alexlutsenko7/A_Computer/docs/LTari_Keys.docx

LTari — keys

Atari 800XL / 130XE (PAL) on the QMTECH Cyclone IV board: AltirraOS and Altirra BASIC, SD card disk drive (.atr), .xex and cartridges (.car), snapshots, 60 / 50 Hz video, Bluetooth audio (build of 2 November 2026)

All keys below are on the USB keyboard unless a board button is named. The machine menu is described in L64_Keys.docx; LTari has two entries there: 3 LTari 800 (800XL, 64 KB) and 4 LTari 130 (130XE, 128 KB).

# Machine keys

Key | What it does | Notes
F12, keypad / or NumLock | Opens / closes the SD card browser | Lists folders and the .atr, .xex and .car files. See "Usage cases" below.
Alt + F2 / F3 / F4 | The Atari's START / SELECT / OPTION | Held as long as the keys are held. OPTION held while the Atari starts switches BASIC off: Alt + F4 held while pressing KEY0 without a disk (for an .atr the browser asks).
Alt + F5 | The Atari's Reset key | A warm start: BASIC keeps its program.
Alt + F6 | The Atari's Help key
Pause, Alt + F7 | The Atari's Break key
F3 | Opens the Bluetooth audio menu | As on the other machines: scan, connect, PIN, volume. F3 or Esc closes it.
F4 | Opens the joystick menu | DB9-1 = stick 0 (default; player 1 in most games) or swapped. Up / Down, Enter selects, F4 or Esc closes.
F8 | Swaps the video between 60 Hz and 50 Hz | After power-up the picture is 640x480 at 60 Hz; F8 gives 720x576 at 50 Hz. The Atari itself always runs at its real 50 Hz (PAL); at 60 Hz every fifth picture is shown twice. The 50 Hz mode shows every picture once.
F2 | Saves a snapshot | The Atari stops; type a name, Enter saves NAME.A8S in the browser's current folder (Esc: no file), then it runs on. Choosing the .a8s in the browser loads it.
Print Screen | Saves the picture | As SCRNnnnn.BMP (376 x 240, 256 colours) in the browser's current folder.
KEY0 (board button W13) | Resets everything | A cold start: memory cleared, disk and cartridge taken out; the ESP32 restarts.
Ctrl + Alt + Del, or KEY1 (board button Y13) | Back to the machine menu | Ctrl + Alt + Del acts when the keys are released.

F5, F6 and saving to tape are not used on LTari: they show a note or do nothing.

## Browser keys

Key (browser open) | Action
Up / Down, keypad 8 / 2, F9 / F10 | Moves the selection (held: repeats)
Left / Right, keypad 4 / 6, Page Up / Page Down | One page up / down
Enter, keypad Enter, F11 | Opens the folder, or uses the file (see the usage cases); an .atr boots
Shift + Enter on an .atr | Changes the disk in D1: only; the Atari runs on ("insert disk 2")
Enter on an .atr, then F1 / F2 | Boots it with BASIC off (F1) or on (F2); Esc goes back to the list
Esc, Backspace | Up one folder; in the top folder closes the browser
F12 | Closes the browser

While the browser is open the Atari sees no keys.

# Usage cases

## Starting

1. In the machine menu choose 3 LTari 800 or 4 LTari 130. No ROM files are needed: AltirraOS and Altirra BASIC (free replacements by Avery Lee) are in the flash.
2. The monitor gets no signal for about 2 seconds, then the screen turns blue. With no disk the OS asks the disk drive for about a second, then Altirra 8K BASIC shows Ready.

## Booting a disk (.atr)

1. Press F12, choose the .atr file and press Enter. Three lines ask How do you want to load it: <F1> No BASIC <F2> with BASIC; press F1 or F2 (Esc goes back to the list).
2. The note says D1: name; the disk is in drive 1 and the Atari restarts and boots from it.
3. The disk stays in until another one is chosen or KEY0 is pressed. Programs write to it as to a real disk: the .atr on the card changes.
4. Disks made for the old Atari 400 / 800 often need BASIC off (e.g. M.U.L.E.: with BASIC on it hangs on a half-drawn screen): choose F1. The OPTION key is held for you while the Atari starts.
5. To protect an .atr, make the file read-only on the PC (Properties > Read-only): writing then fails with an error, as on a write-protected disk.

## Changing disks (multi-disk programs)

1. Boot the first disk as above (Enter, then F1 or F2).
2. When the program asks for the next disk or side: F12, choose that .atr and press Shift + Enter. The note says Disk changed, D1: name; the Atari was not restarted.
3. Press the key the program asks for (often Return or START) to go on.

## BASIC with a DOS disk

1. Boot a DOS disk (e.g. DOS 2.5 .atr) as above with F2 (with BASIC). BASIC starts with Ready.
2. SAVE "D:NAME" and LOAD "D:NAME" save and load BASIC programs on that disk; DOS opens the DOS menu.

## Running a program file (.xex)

1. Press F12, choose the .xex file and press Enter. The note says Run: name.
2. The Atari restarts, a small loader switches BASIC off and loads the file from a virtual disk (a few seconds), then the program starts.
3. The loader uses memory $0700-$08FF: a program that loads there does not work this way (use an .atr version).

## Plugging in a cartridge (.car)

1. Press F12, choose the .car file and press Enter. The note says Cartridge: name, and the Atari restarts into the cartridge.
2. Supported: standard 8 KB and 16 KB cartridges, Atarimax 128 KB and 1 MB (many newer games). Other types say Cart type not yet.
3. Choosing an .atr or .xex, or KEY0, takes the cartridge out again.

## Without BASIC

1. With a disk: in the browser press Enter on the .atr, then F1 (No BASIC).
2. Without a disk: hold Alt + F4 and press KEY0; keep holding until the screen comes up. (KEY0 also takes a disk out, so use the browser way for disks.)
3. Signs that a disk needs BASIC off: it hangs while starting or shows a half-drawn screen. Most disks for the old 400 / 800 need it; .xex files switch BASIC off by themselves.

## Snapshots

1. Press F2: the Atari stops. Type a name (letters / digits, up to 8) and press Enter: NAME.A8S is saved in the browser's current folder (64 KB file on the 800, 128 KB on the 130). Esc saves nothing. The Atari then runs on.
2. To go back to that moment: F12, choose the .a8s, Enter. Memory, CPU and chip registers are restored and the program runs on from there.
3. Load it on the same model (800 or 130) it was saved on. A cartridge game: load the same .car first, then the snapshot. A disk game that loads more later: if the note says Loaded; disk was NAME, put that disk in with Shift + Enter.
4. Not kept: the exact position in the picture and the chips' internal counters; the program is back in step within a frame.

## 60 Hz or 50 Hz

1. LTari starts at 640x480, 60 Hz. If your monitor also accepts 50 Hz, F8 shows the Atari's own 50 Hz with perfectly smooth scrolling; F8 again goes back to 60 Hz.

## Sound on Bluetooth headphones or a speaker

1. POKEY's sound goes to the 3.5 mm jack and, through the ESP32, to Bluetooth. Press F3, choose Scan, then the device, and Enter.

## Screenshots

1. Press Print Screen: the picture is saved as SCRNnnnn.BMP in the folder the browser shows (the card's top folder after a start).

# The Atari keyboard on a USB keyboard

Keys that the Atari has are on the same PC keys; the others are on keys at the same places as on the Atari:

USB key | Atari key
Letters, digits, Return, Space, Tab, Esc, Caps Lock, Backspace | The same keys (Backspace = Delete / Back S)
- = ; , . / | The same keys
' (apostrophe) | + (Shift: \)
\ (backslash) | * (Shift: ^)
[ and ] | < and > (Shift: Clear / Insert line)
` (back quote) | Inverse video (the Atari logo key)
Up / Down / Left / Right | The cursor keys (Control + - = + *)
Home | Clear screen (Shift + <)
Delete / Insert | Delete / insert a character (Control + Back S / >)
Shift, Ctrl | Shift, Control
Shift + 2 / Shift + 7 / Shift + 8 | " / ' / @ (as printed on the Atari)

# Good to know

- SD card: FAT32 or FAT16, not exFAT. The browser shows folders first, then files, up to 320 per folder.
- The LTari 130 has 128 KB (the 130XE's extra 64 KB in banks of 16 KB); the LTari 800 has 64 KB.
- The chips are new designs from the Atari documentation; some rare hardware tricks may still be missing (see LTari/ep4_ce15/README.md).
