alexlutsenko7/A_Computer/Extra_PCB_CycloneIV_R2/jlcpcb/Extra_PCB_CycloneIV_R2_BOM.csv

Comment | Designator | Footprint | LCSC Part #
6p8 | C1,C2,C3,C4,C5 | C_0603_1608Metric | C318672
0.1u | C6,C8,C13,C15,C16,C17,C21,C22,C26,C28,C29 | C_0603_1608Metric | C14663
10u | C7,C9,C10,C23,C24,C25,C27 | C_0805_2012Metric | C15850
1u | C11,C14 | C_0603_1608Metric | C15849
22u | C12 | C_0805_2012Metric | C45783
4.7u | C18 | C_0603_1608Metric | C19666
100u | C19,C20 | C_1206_3216Metric | C15008
VGA | J2 | DSUB-15-HD_Socket_Horizontal_P2.29x2.54mm_CONNFLY_DS1038 | C75754
Audio out | J3 | Jack_3.5mm_KoreanHropartsElec_PJ-320D-4A_Horizontal | C95562
Joystick 2 / Joystick 1 | J4,J6 | DSUB-9_Pins_Horizontal_P2.77x2.84mm_EdgePinOffset7.70mm_Housed_MountingHolesOffset9.12mm | C75750
USB-C 5V / console | J5 | USB_C_Receptacle_HRO_TYPE-C-31-M-12 | C165948
microSD | J7 | microSD_HC_Molex_104031-0811 | C585350
USB 5V (HDMI dongle) / USB keyboard | J8,J9 | USB_A_Connfly_DS1095 | C19944603
MMBT3904 | Q1,Q2 | SOT-23 | C20526
523 | R1,R5,R9 | R_0603_1608Metric | C23199
1.05k | R2,R6,R10 | R_0603_1608Metric | C22832
2.1k | R3,R7,R11 | R_0603_1608Metric | C22902
4.22k | R4,R8,R12 | R_0603_1608Metric | C23042
22 | R13,R14 | R_0603_1608Metric | C23345
3k3 | R15,R16,R17,R18,R19,R20,R21,R22,R23,R24 | R_0603_1608Metric | C22978
10k | R25,R26,R27,R28,R29,R34,R35,R36,R37 | R_0603_1608Metric | C25804
68 | R30 | R_0603_1608Metric | C27592
2.2k | R31,R32 | R_0603_1608Metric | C4190
1k | R33,R42 | R_0603_1608Metric | C21190
5.1k | R38,R39 | R_0603_1608Metric | C23186
22k | R40 | R_0603_1608Metric | C31850
47.5k | R41 | R_0603_1608Metric | C23061
BOOT / EN | SW1,SW2 | SW_SPST_PTS810 | C116501
LDL1117S33R | U1 | SOT-223-3_TabPin2 | C435835
ESP32-WROVER-E-N16R8 | U2 | ESP32-WROVER-E | C529589
CP2102N-A02-GQFN24 | U3 | QFN-24-1EP_4x4mm_P0.5mm_EP2.6x2.6mm | C969151
CH9350L | U4 | LQFP-48_7x7mm_P0.5mm | C109472
USBLC6-2SC6 | U5,U6 | SOT-23-6 | C7519
