alexlutsenko7/A_Computer/Extra_PCB_CycloneIV/jlcpcb/Extra_PCB_CycloneIV_BOM.csv

Comment | Designator | Footprint | LCSC Part #
6p8 | C1,C2,C3,C4,C5 | C_0603_1608Metric | C318672
0.1u | C6,C13,C14,C15,C16,C17 | C_0603_1608Metric | C14663
10u | C7,C11,C12 | C_0805_2012Metric | C15850
0.1u | C8 | C_Disc_D4.7mm_W2.5mm_P5.00mm | C84772
10u | C9,C10 | C_Disc_D4.7mm_W2.5mm_P5.00mm | C531341
VGA | J2 | DSUB-15-HD_Socket_Horizontal_P2.29x2.54mm_CONNFLY_DS1038 | C75754
Audio out | J3 | Jack_3.5mm_KoreanHropartsElec_PJ-320D-4A_Horizontal | C95562
Joystick 1 / Joystick 2 | J4,J6 | DSUB-9_Pins_Horizontal_P2.77x2.84mm_EdgePinOffset7.70mm_Housed_MountingHolesOffset9.12mm | C75750
microSD | J7 | microSD_HC_Molex_104031-0811 | C585350
523 | R1,R5,R9 | R_0603_1608Metric | C23199
1.05k | R2,R6,R10 | R_0603_1608Metric | C22832
2.1k | R3,R7,R11 | R_0603_1608Metric | C22902
4.22k | R4,R8,R12 | R_0603_1608Metric | C23042
22 | R13,R14 | R_0603_1608Metric | C23345
3k3 | R15,R16,R17,R18,R19,R20,R21,R22,R23,R24 | R_0603_1608Metric | C22978
10k | R25,R26,R27,R28,R29 | R_0603_1608Metric | C25804
68 | R30 | R_0603_1608Metric | C27592
2.2k | R31,R32 | R_0603_1608Metric | C4190
1k | R33 | R_0603_1608Metric | C21190
7803 module | U1 | Module_7803_SIP-3_P2.54mm_Reserve15x12mm | C5369643
