alexlutsenko7/A_Computer/INSTALL/README.txt

L - installing the machines

1. Format a microSD card as FAT32 or FAT16 (not exFAT).
2. Copy LUPDATE.BIN to the root folder of the card.
3. Put the card into the board and switch it on. Wait for "Update complete." (about one minute).

Step by step and in your language: <language>/L_Installation_Guide_<language>.pdf.
Keys, menus, joysticks: <language>/L_User_Manual_<language>.pdf.
Languages: EN English, SP Espanol, PT Portugues, DE Deutsch, UA Ukrainska, RU Russkiy, CN Zhongwen, KR Hangugeo,
JP Nihongo.

Not included: games and other programs, and the Commodore 64 ROMs (copyrighted). Get them yourself; see section 4
of the installation guide.
