alexlutsenko7/A_Computer/docs/L_Build_and_Install.docx

L — build and install

From the sources to a working board: the FPGA images, the one .jic file, the ESP32 firmware, the SD card and the ROMs (state of 11 November 2026)

# 1. What goes where

The finished system has three places that hold software. Each is built and loaded separately:

Where | What | How it gets there
Configuration flash on the core board (W25Q64, 8 MB) | The machine menu, both machines, the Spectrum ROMs; later the C64 ROMs | One file, AMenu/ep4_ce15/output_files/L.jic, programmed over JTAG (USB-Blaster). The C64 ROMs are added by the ESP32 (section 6).
ESP32 (system controller on the I/O board) | SD card loader, on-screen menus, ROM installer, Bluetooth audio | The Arduino sketch ESP32/v2, uploaded over USB (section 4).
microSD card (in the I/O board's socket, read by the ESP32) | Games, tapes, disks, snapshots, and your own C64 ROM files | Copied on a PC (section 5).

At power-up the FPGA always loads the machine menu from flash address 0. Choosing a machine loads that machine's image (Cyclone IV remote update); KEY1 or Ctrl+Alt+Del returns to the menu. Each machine copies its ROMs from the flash into the SDRAM every time it starts.

## Flash layout

Address | Size | Contents
0x000000 | ~500 KB | AMenu, the machine menu (factory image)
0x100000 | ~500 KB | LSpectrum, ZX Spectrum 128K (application image)
0x200000 | ~500 KB | L64, Commodore 64 (application image)
0x300000 | ~500 KB | LTari 800, Atari 800XL (revision LTari800)
0x400000 | ~500 KB | LTari 130, Atari 130XE (revision LTari)
0x500000 | 48 KB | Spectrum ROMs: 128K ROM set + the F1 diagnostics slot (LSpectrum/ep4_ce15/roms48k.hex; the public copy has 48K BASIC there)
0x540000 | 28 KB | LTari ROMs: AltirraOS + Altirra BASIC (free; LTari/ep4_ce15/roms/atarirom.hex)
0x580000 | 48 KB | C64 ROMs: CHAR, BASIC, KERNAL and 1541 DOS. Not in the .jic: written by the ESP32 from your files on the SD card
0x600000 ... | free | room for further machines

Every image has a 1 MB slot, so boards with a larger FPGA use the same layout. The addresses are fixed in three places that must agree: the menu (AMenu/ep4_ce15/rtl/AMenu.v, parameter MACHINE_ADDR), the .cof file (AMenu/ep4_ce15/L.cof) and the machines' ROM loaders (rom_loader.v FLASH_ADDR: its default 0x500000 for the Spectrum, 0x580000 set in c64_system.v, 0x540000 in atari_system.v), plus the ESP32 (update.cpp slots, c64.cpp ROM_BASE) and AMenu/ep4_ce15/tools/mk_update.py (skipped C64 area, menu end). The two LTari images are two revisions of one project: LTari800 (0x300000, 800XL) and LTari (0x400000, 130XE).

# 2. Tools

Tool | Notes
Quartus Prime 25.1std Lite (Windows) | Free edition; includes the Programmer and quartus_cpf. The scripts are written for WSL and call the Windows tools in C:\Altera\quartus\bin64.
USB-Blaster | JTAG cable to the core board's JTAG header.
Arduino IDE / arduino-cli | Core esp32 3.3.2 (Espressif), board ESP32 Dev Module, default partition scheme. arduino-cli comes with the Arduino IDE.
Arduino libraries | ESP32-A2DP 1.8.11 (Phil Schatzmann; not in the Library Manager: copy the GitHub release into the sketchbook's libraries folder) and AAudioLinkFix (copy ESP32/v2/libraries/AAudioLinkFix there too).
Python 3 (optional) | For the tools: L64/ep4_ce15/tools/mk_c64rom.py (a local C64 ROM image for tests), mk_d64.py (a test disk).
Questa FSE (optional) | Intel's free simulator, for the testbenches; not needed to build.

# 3. Building the FPGA images and the .jic

## 3.1 The four Quartus projects

Every project folder (AMenu, LSpectrum, L64, LTari) has one subfolder per core board: ep4_ce15/ for the QMTECH Cyclone IV EP4CE15 board, with all sources, simulations and tools, and 10cl025/ for the QMTECH Cyclone 10 LP 10CL025 board (section 3.4). This section builds for the EP4CE15 board.

Each machine is its own Quartus project; LTari has two revisions (800 and 130). Compile all five (order does not matter); each produces a .sof in its output_files folder:

cd AMenu/ep4_ce15 && quartus_sh --flow compile AMenu # -> output_files/AMenu.sof

cd LSpectrum/ep4_ce15 && quartus_sh --flow compile LSpectrum # -> output_files/LSpectrum.sof

cd L64/ep4_ce15 && quartus_sh --flow compile L64 # -> output_files/L64.sof

cd LTari/ep4_ce15 && quartus_sh --flow compile LTari # -> output_files/LTari.sof (130XE)

cd LTari/ep4_ce15 && quartus_sh --flow compile LTari -c LTari800 # -> output_files/LTari800.sof (800XL)

- In the Quartus GUI: open the .qpf, Processing > Start Compilation.
- A compile takes a few minutes per project. Check that timing is met: the Timing Analyzer summary must show no negative slack (all are fully constrained).
- All images are compiled for remote update (STRATIXIII_UPDATE_MODE REMOTE in the .qsf). Keep that setting: without it the menu cannot start the machine.
- The source files each project uses are listed in its .qsf. The machines share some files in LSpectrum/ep4_ce15/rtl/ (SDRAM controller, ROM loader, tape loader, ESP32 link); LTari also uses L64's c64_video.v (OSD).

## 3.2 Assembling the one .jic

The four .sof files (LTari's twice) and the Spectrum and Atari ROMs are combined into one JTAG Indirect Configuration file, as described by AMenu/ep4_ce15/L.cof:

cd AMenu/ep4_ce15

quartus_cpf -c L.cof # -> output_files/L.jic (+ output_files/L.map)

Part of L.cof | Setting
Device | EPCS64 (the W25Q64 behaves as one), FPGA EP4CE15, Active Serial
Page_0 | output_files/AMenu.sof at 0x000000
Page_1 | ../../LSpectrum/ep4_ce15/output_files/LSpectrum.sof, start address 0x100000
Page_2 | ../../L64/ep4_ce15/output_files/L64.sof, start address 0x200000
Page_3 | ../../LTari/ep4_ce15/output_files/LTari800.sof, start address 0x300000
Page_4 | ../../LTari/ep4_ce15/output_files/LTari.sof, start address 0x400000
Hex data | ../../LSpectrum/ep4_ce15/roms48k.hex at 0x500000 and ../../LTari/ep4_ce15/roms/atarirom.hex at 0x540000 (relative)
Options | EPCS ID check off; a .map file with the addresses

L.map lists where each part ended up; compare it with the flash layout in section 1. In the Quartus GUI the same file is made with File > Convert Programming Files > Open Conversion Setup Data (L.cof) > Generate.

The Spectrum ROM file roms48k.hex is part of the project (Amstrad allows the ROMs for emulator use). The .jic stores its bytes bit-reversed; the ROM loader recognises that by the first byte, so nothing has to be done.

## 3.3 Programming the board

1. Connect the USB-Blaster to the core board's JTAG header and power the board.
2. Quartus Programmer: Hardware Setup = USB-Blaster, mode JTAG, Add File AMenu/ep4_ce15/output_files/L.jic, tick Program/Configure and Verify, Start, and wait for 100 % before touching the board or the cable. From the command line:

quartus_pgm -c USB-Blaster -m JTAG -o "ipv;AMenu/ep4_ce15/output_files/L.jic"

Without Verify, an interrupted write is not noticed: the menu then reports reason 08 (a CRC error in that machine's image) when the machine is chosen. Program the .jic again, with Verify.

3. The Programmer first loads a small flash loader into the FPGA, then writes the flash. When it reports success, switch the board off and on: the menu appears.

For development, a single machine's .sof can be loaded straight into the FPGA over JTAG (it is lost at power-off). The flash is not touched; KEY1 then goes to the menu in the flash.

## 3.4 The Cyclone 10 LP core board (10CL025)

The second core board, QMTECH's 10CL025YU256I7G, has the same size and headers, the same SDRAM and flash. Its projects are in the 10cl025/ subfolders. They hold only the Quartus project and its outputs: the sources, the .sdc and the ROM images are those of ep4_ce15/. State of 11 November 2026: the SDRAM test runs on the board; the menu and the machines build and meet timing but have not been tried on hardware.

python3 tools/mk_10cl025_qsf.py # makes every 10cl025/*.qsf from the ep4_ce15 one

cd AMenu/10cl025 && quartus_sh --flow compile AMenu

cd LSpectrum/10cl025 && quartus_sh --flow compile LSpectrum

cd L64/10cl025 && quartus_sh --flow compile L64

cd LTari/10cl025 && quartus_sh --flow compile LTari

cd LTari/10cl025 && quartus_sh --flow compile LTari -c LTari800

cd AMenu/10cl025 && quartus_cpf -c L.cof # -> output_files/L.jic for the 10CL025

cd AMenu/10cl025 && python3 ../ep4_ce15/tools/mk_update.py # -> output_files/LUPDATE.BIN for the 10CL025

- The 10cl025/*.qsf files are generated: change the ep4_ce15 .qsf (or the tool) and run the tool again. It replaces the device, translates every ball name (on-board parts by signal, the I/O board's signals by their pin of header U8) and points the file paths to ../ep4_ce15.
- Needs the Cyclone 10 LP device support in Quartus (Tools > Install Devices).
- The board has one user key (KEY0). KEY1 is on header U7 pin 7 (ball G1) with a weak pull-up, where a button to ground can be wired; the board's nCONFIG button also returns to the machine menu.
- An `L.jic` or `LUPDATE.BIN` is for one core board only. The update file has no board mark: the file of the other board would leave the FPGA without a valid image, and the board would need the USB-Blaster and its own L.jic.
- Pins: docs/BOARD_PINOUT.md. Flash layout and addresses are the same on both boards.

# 4. The ESP32 firmware

The same firmware serves all machines: it waits for a machine's core ID on the SPI link (LSpectrum 5A580001, L64 43360001, LTari 41540001) and restarts whenever the machine changes.

1. Install the esp32 core 3.3.2 and the two libraries (section 2).
2. Connect the ESP32 board by USB; note its COM port (COM10 on the development PC).
3. Compile and upload, in the top folder of the project (I/O board revision 1; for revision 2 the sketch is ESP32/v2 and the board options are in its README):

arduino-cli compile -b esp32:esp32:esp32 -u -p COM10 ESP32/v1

Or open ESP32/v2/v2.ino in the Arduino IDE, board "ESP32 Dev Module", and Upload. (I/O board revision 1: ESP32/v1/v1.ino.) The sketch uses about 1.17 MB of the 1.25 MB app partition. A change in the ESP32 sources needs only this step; the FPGA flash stays as it is.

# 5. The SD card

1. Use a microSD card formatted FAT32 (or FAT16). exFAT is not supported: most cards above 32 GB come as exFAT and must be reformatted.
2. For L64, make the folder /ROMS/C64/ and copy Commodore ROM files into it that you are entitled to use (they are copyrighted and not part of the project): read from a C64 and 1541 you own, or licensed copies:

File name starts with | Size | Typical file name
KERNAL | 8 KB | kernal-901227-03.bin
BASIC | 8 KB | basic-901226-01.bin
CHAR | 4 KB | chargen-901225-01.bin
DOS1541 or 1541 | 16 KB | dos1541-325302-01+901229-05.bin (without it there is no disk drive)

3. Put games anywhere on the card, in folders as you like (up to 320 entries per folder): Spectrum .tap / .tzx / .z80, C64 .d64 / .prg / .t64 / .tap / .a64. Saved tapes and snapshots are written into the folder the browser is in.

The Spectrum needs nothing on the card to start; its ROMs are in the .jic. The card can be inserted or changed at any time (the browser reads it again).

SD card (FAT32)

├── ROMS/

│ └── C64/

│ ├── kernal-901227-03.bin

│ ├── basic-901226-01.bin

│ ├── chargen-901225-01.bin

│ └── dos1541-325302-01+901229-05.bin

├── Spectrum/ ... (.tap .tzx .z80, any folder names)

└── C64/ ... (.d64 .prg .t64 .tap .a64)

# 6. How the ROMs are used

## 6.1 ZX Spectrum

- The 128K ROMs and the F1 diagnostics slot are in the flash at 0x500000 (from the .jic). The public image has a copy of the 48K BASIC ROM in that slot (DiagROM's licence is not known); LSpectrum/ep4_ce15/tools/mk_roms48k.py builds it with your own DiagROM.
- At every start and reset (power-up via the menu, KEY0) the FPGA's ROM loader copies the 48 KB from the flash into the SDRAM, then starts the Z80. F1 held at that moment selects the diagnostics slot.
- If the flash holds no ROM image (first byte wrong), the board LED blinks fast: program the .jic.

## 6.2 Commodore 64

1. When L64 starts, its ROM loader copies 48 KB from flash 0x580000 into the SDRAM (CHAR, BASIC, KERNAL) and the 1541 DOS ROM into the drive's own memory. The image starts with the header "L64 ROMS"; byte 13 says whether a 1541 ROM is included.
2. The ESP32 checks that header. If the flash has no C64 ROMs yet, it shows "No ROMs in the flash yet", reads KERNAL*, BASIC*, CHAR* and DOS1541* / 1541* from /ROMS/C64/, builds the 48 KB image, writes it into the flash through the FPGA (flash pass-through, sector erase + page program), reads it back to verify, and tells the FPGA to reload: the C64 starts with its ROMs. This takes a few seconds and happens once.
3. From then on L64 starts without the SD card: the ROMs come from the flash every time L64 is started and after KEY0.
4. If the files are missing, the screen says where to put them; add them and press KEY0. Without a DOS1541 file the C64 works but has no disk drive (DEVICE NOT PRESENT); the board LED blinks fast while there is no ROM image at all.

Changing the C64 ROMs later (for example adding the 1541 ROM afterwards) is not automatic yet: the ESP32 installs only when the flash has no C64 ROMs. To make it install again, erase the flash before programming the .jic (Programmer: tick Erase as well as Program/Configure), or erase only the sectors at 0x200000; at the next L64 start the files are installed from the card. Keep the ROM files on the card for that reason.

For local tests only, L64/ep4_ce15/tools/mk_c64rom.py KERNAL BASIC CHAR [DOS1541] OUT makes the same 48 KB image as Intel HEX (to add to a private copy of the .cof at 0x580000) and as a .mem file for the simulation. Such files contain the Commodore ROMs: keep them in the git-ignored L64/ep4_ce15/roms_local/ and never publish a .jic that contains them.

# 7. Updating from the SD card (LUPDATE.BIN)

A board with the machine menu of 30 October 2026 or later updates itself from the card; no USB-Blaster is needed. The update file LUPDATE.BIN has the same contents as L.jic, for the same core board (section 3.4).

1. Copy LUPDATE.BIN to the root folder of the SD card and put the card in.
2. Switch the board on. While the machine menu is shown, the ESP32 finds the file and checks it (header and a CRC-32 over the whole image). The screen shows L update with a progress bar; the menu takes no keys meanwhile. Do not switch off.
3. The ESP32 compares the flash with the file in 4 KB sectors and rewrites only those that differ, each read back: the machines first, the menu last. A small change takes a few minutes of checking and seconds of writing; a full install about 3-4 minutes.
4. When everything checked out, the ESP32 deletes LUPDATE.BIN. If the menu itself changed, the screen says Switch the board off and on; otherwise the menu comes back and the new machines start at once.

Situation | What happens
The file is damaged or not an update file | "not a valid update file": nothing is written, the file stays
The power fails during the update | The file is still on the card; the update runs again at the next start and finishes the job
The power fails while the menu's own sectors are written | The only risky moment (only when the menu changed, written last): the board may need the USB-Blaster and L.jic again
The flash is already up to date | Nothing is written; "(the flash was up to date)"; the file is deleted
C64 ROMs installed by the ESP32 | Never touched (flash 0x580000-0x5FFFFF is skipped)

Making the file, after building the images (section 3), in AMenu/ep4_ce15/:

python3 tools/mk_update.py --label "L 2026-10-30" # -> output_files/LUPDATE.BIN

The tool converts L.cof into a raw flash image (.pof -> .rpd, the flash contents byte for byte) and writes it after a 256-byte header: "LUPDATE1", the image length, its CRC-32, the skipped range (the C64 ROM area), the end of the menu's area and the label shown during the update. The ESP32 code is ESP32/v2/src/update.cpp; its PC test (ESP32_test/v2/test/update_test.cpp, part of run_host_test.sh) runs updates against a flash model, including power cuts at random moments.

# 8. Boards shipped with the loader

AMenu/ep4_ce15/output_files/L_loader.jic holds only the machine menu (the rest of the flash blank): no machines and no ROMs. A board can be passed on with it, and the user installs everything from the public release.

1. Make it in AMenu/ep4_ce15/: python3 tools/mk_update.py --loader.
2. Program L_loader.jic as in 3.3. It holds the menu and blank data up to the end of the 8 MB flash: the Programmer erases only where a .jic has data (its Erase option did not clear old machines on hardware), so this file wipes a used board completely, C64 ROMs included. Then the ESP32 firmware as in section 4.
3. At power-up the board shows No machines installed. Copy LUPDATE.BIN to the SD card's root folder. It looks at the card every 2 seconds.
4. The user copies LUPDATE.BIN from the repository (AMenu/ep4_ce15/output_files/) to the card: the update installs all machines and the Spectrum / Atari ROMs (section 7). For L64 the user adds the C64 ROM files as in section 5.

# 9. Checklist after installing

Check | Expected
Power on | The machine menu: LSpectrum, L64, LTari 800, LTari 130
Start LSpectrum (1) | The 128K menu; F12 shows the card's files (the ESP32 answers)
KEY1, then start L64 (2) | First time: "No ROMs in the flash yet", installing, then the BASIC screen; later: the BASIC screen at once, 38911 BASIC BYTES FREE
F12 in L64, a .d64, Enter | LOAD"*",8,1 is typed, the drive LED (board LED) is on, the program loads in turbo
Ctrl+Alt+Del, then start LTari 130 (4) | Blue screen, then "Altirra 8K BASIC 1.59" and Ready
F8 | The picture switches between 60 Hz (640x480) and 50 Hz (720x576)
F3 | The Bluetooth menu (the ESP32's Bluetooth part answers)

Licences, our own work and the same build steps in one file: BUILDING_AND_LICENSES.md in the repository root. Keys and usage of each machine: docs/LSpectrum_Keys.docx, docs/L64_Keys.docx and docs/LTari_Keys.docx. Wiring of the boards: docs/LSpectrum_Connection.docx. Third-party parts and licences: docs/L_Third_Party.docx.
