alexlutsenko7/A_Computer/docs/L64_Test_Plan.xlsx

Sheet: Test Plan
ID | Area | Test | Steps | Expected result | Needs | Result | Notes
T01 | Start | Clean start into BASIC | Power on. In the menu choose 2 L64. | Monitor: no signal for ~2-3 s, then the BASIC screen. No coloured line at the right. Board LED off. | - | Pass
T02 | Start | KEY0 restart | In BASIC type 10 PRINT "X", then press KEY0. | No signal ~2-3 s, then a fresh BASIC screen; LIST shows nothing (RAM cleared). ESP32 OSD works afterwards (F12). | - | Pass
T03 | Start | Krackout + Ctrl+Alt+Del | Load Krackout (.d64), let it start. Ctrl+Alt+Del, choose L64 again, load Krackout again. | C64 starts into BASIC (no flashing pattern). Krackout loads and runs the second time too. | Good copy of cp krackout.d64 on the card | Pass
T04 | Start | Krackout + KEY0 | Load Krackout, let it start, press KEY0. Load Krackout again. | BASIC after KEY0; Krackout loads again. On the PC the card's .d64 is unchanged (compare with the local copy). | Good copy of cp krackout.d64 | Pass
T05 | Start | Machine switching | Menu -> LSpectrum -> KEY1 -> L64 -> Ctrl+Alt+Del -> LSpectrum, a few rounds. | Each machine starts; the ESP32 OSD (F12) works in each; no restart loop of the ESP32. | - | Pass
T06 | Video | No right-edge line | Do 5 starts (menu and KEY0) in BASIC, light-blue border. | Never a line next to the right border. Optional scope: HSYNC spike on a colour line smaller than before (+-40 mV). | Optional: scope | Pass
T07 | Video | F8 50 / 60 Hz | F8, wait, F8 again. | 50 Hz picture, then 60 Hz again; the C64 runs on. | Monitor with 50 Hz | Pass
T08 | Disk | Directory | F12, choose a .d64. Esc if the LOAD starts. LOAD"$",8 and LIST. | LOAD"*",8,1 typed at the prompt; directory listed. | Any .d64 | Pass
T09 | Disk | Save to disk | On a COPY of a .d64 with free blocks: 10 PRINT "DISK OK" ; SAVE "DTEST",8 | LED on while saving, READY., no blinking afterwards. LOAD"$",8 / LIST: DTEST listed, blocks free reduced. | Spare .d64 (copy)
T10 | Disk | Saved file survives a restart | Ctrl+Alt+Del, L64, F12 the same .d64, LOAD"DTEST",8, RUN. | Prints DISK OK. On the PC: only BAM / directory / DTEST sectors differ from the copy; no track of FF. | Same .d64; PC to compare
T11 | Disk | Scratch and rename | SAVE "DTEST2",8 ; OPEN15,8,15,"R:NEW=DTEST2":CLOSE15 ; OPEN15,8,15,"S:DTEST":CLOSE15 ; directory. | NEW listed, DTEST and DTEST2 gone, blocks free back up. | Same .d64
T12 | Disk | Read-only .d64 | On the PC make a .d64 copy read-only (Properties > Read-only). F12 it, then SAVE "RO",8. | ?WRITE PROTECT / LED blinks (DOS error 26); on the PC the file is unchanged. | Read-only .d64 copy
T13 | Disk | Disk change in BASIC | F12 disk A, LOAD"$",8, LIST. F12 disk B, LOAD"$",8, LIST. | Second listing shows disk B's name and files (not disk A's). | Two different .d64
T14 | Disk | Disk change in a running game | Start a multi-disk game (or any program), then F12 another .d64 while it runs. | Nothing is typed into the program; a game asking for disk 2 continues loading from it. | Multi-disk game, or any game + 2nd .d64
T15 | Disk | Normal speed load | F6 (normal), load a .d64 game. | Loads at 1541 speed (~1-2 min) and runs. F6 back to turbo. | Any .d64 game
T16 | Tape | Save to tape, load back | 10 PRINT "TAPE OK". F12, [Save to this folder], name TTEST, Enter. SAVE "TTEST". READY., then F12. KEY0, LOAD, F12 TTEST.TAP. | TTEST.TAP on the card; FOUND TTEST, LIST shows the line, RUN prints TAPE OK. | -
T17 | Tape | Tape at normal speed | As above with F6 = normal. | Same result, slower. | -
T18 | Tape | Commercial .tap game | LOAD, then F12 a .tap game. Try F11 (pause / continue) and F7 (stop). | Loads and runs in turbo; pause and stop work. If a turbo loader fails: F6 normal and retry. | .tap game
T19 | Files | BASIC .prg | F12 a BASIC .prg. | Program in memory and started (RUN typed). | BASIC .prg | Pass
T20 | Files | Machine-code .prg | F12 a machine-code .prg. | Bottom line shows the load range (e.g. $C000-$C3FF); the program's SYS starts it. | Machine-code .prg
T21 | Files | .t64 | F12 a .t64. | Loaded as the .prg tests. | .t64 file
T22 | Sound | SID 6581 / 8580 (F5) | Play music with filter, press F5, again F5. Listen on the jack and Bluetooth. | Audible filter difference; OSD shows the SID type; no silence or glitch. | Game with music; BT speaker | Pass
T23 | Sound | Bluetooth volume | Connect the BT speaker (F3). | Volume right from the start; reconnects after KEY0. | BT speaker
T24 | Joystick | F4 mode 1: DB9-1 = port 2 | F4, choose mode 1. In BASIC: PRINT PEEK(56320) with DB9-1 directions / fire; PRINT PEEK(56321) with DB9-2. | DB9-1 changes port 2 ($DC00), DB9-2 port 1 ($DC01). Game control works. | 2 joysticks
T25 | Joystick | F4 mode 2: swapped | F4, mode 2; same checks. | DB9-1 on port 1, DB9-2 on port 2. | 2 joysticks
T26 | Joystick | F4 mode 3: both on port 2 | F4, mode 3; same checks. | Both DB9 move port 2. | 2 joysticks
T27 | Snapshots | F2 save / load | In a game (drive idle) F2, name, Enter. KEY0. F12 the .A64. | Game continues where it was saved. | Any game
T28 | Snapshots | Print Screen | Print Screen in BASIC and in a game. | SCRNnnnn.BMP on the card shows the screen (400 x 284). | -
T29 | ROMs | 1541 ROM added later | Optional (needs a ROM image without the 1541 ROM in flash): with DOS1541* in /ROMS/C64, start L64. | OSD 'Adding the 1541 ROM to the flash', C64 restarts, the drive works. | Optional
T30 | LSpectrum | Spectrum regression | Start LSpectrum: F12 a .tap and a .z80, F2 snapshot, Print Screen, KEY0. | All work as before (the ESP link changed in both machines). | ZX .tap and .z80 | Pass

Sheet: Summary
L64 final test round
Hardware: L.jic 2026-10-29 12:06 (programmed with verify), ESP32 sketch 1,175,375 bytes
Tests | 30
Pass | 11
Fail | 0
Skipped | 0
Not run yet | 19
Done | 36.66666667%
How to use
Fill in only the yellow columns of 'Test Plan': Result (drop-down: Pass / Fail / Skipped) and Notes.
Notes example: "Fail: LED blinks after SAVE, PRINT shows 26 WRITE PROTECT ON" or "Pass, 1:40 min at normal speed".
Keep a PC copy of every .d64 you write to, and compare after the disk tests.
The counts above update by themselves.
