alexlutsenko7/A_Computer/docs/LTari_Test_Plan.xlsx

Sheet: Test Plan
ID | Area | Test | Steps | Expected result | Needs | Result | Notes
T01 | Start | Menu with four machines | Power on. | The menu lists 1 LSpectrum, 2 L64, 3 LTari 800, 4 LTari 130. | -
T02 | Start | LTari 130 boots | Choose 4 LTari 130 (no disk inserted). | No signal ~2 s, blue screen; ~1 s later "Altirra 8K BASIC 1.59" and "Ready". | -
T03 | Start | 130XE extra memory | In LTari 130 type: POKE 16384,11:POKE 54017,225:POKE 16384,77:POKE 54017,253:?PEEK(16384) | Prints 11 (the 77 went into extended bank 0, not main RAM). | -
T04 | Start | LTari 800 has no extra memory | Ctrl+Alt+Del, choose 3 LTari 800, type the same line as the test before. | Prints 77 (no banking on the 800XL). | -
T05 | Keys | Typing | Type letters, digits, Shift+digits, - = ; , . / and ' \ [ ] ` , Caps Lock, Backspace. | Each key gives the Atari character from the README table; ` toggles inverse video. | -
T06 | Keys | Cursor and editing | Arrows, Home, Delete, Insert on a typed line. | Arrows move the cursor; Home clears the screen; Delete removes / Insert opens a character. | -
T07 | Keys | Break | Type 10 GOTO 10, RUN, then press Pause. | "Stopped at line 10" (or similar) and Ready. | -
T08 | Keys | Console keys | Type 10 ?PEEK(53279):GOTO 10, RUN; hold Alt+F2, then Alt+F3, then Alt+F4; Pause to stop. | 7 with nothing held; 6 / 5 / 3 while START / SELECT / OPTION are held. | -
T09 | Keys | Reset key | Type 10 ?1, then Alt+F5, then LIST. | Screen restarts into Ready; LIST still shows line 10 (warm start keeps the program). | -
T10 | Keys | No BASIC with OPTION | In LTari 130 hold Alt+F4, press KEY0, keep holding until the screen comes up. | No Altirra BASIC banner (the OS's own screen instead). | -
T11 | Sound | POKEY tone | SOUND 0,121,10,8 then SOUND 0,0,0,0 | A steady tone (about middle C) on the audio jack and Bluetooth; silence after the second command. | Speaker or headphones
T12 | Sound | Keyboard click | Type a few keys with sound on. | A short click per key (console speaker). | -
T13 | Joystick | Stick 0 | Type 10 ?STICK(0),STRIG(0):GOTO 10, RUN; move the joystick in DB9-1, press fire. | 15 1 at rest; 14 up, 13 down, 11 left, 7 right; STRIG 0 while fire is held. | Joystick
T14 | Joystick | Stick 1 and F4 swap | Same with STICK(1),STRIG(1) and the joystick in DB9-2; then F4 -> DB9-1 = stick 1. | DB9-2 drives stick 1; after the swap DB9-1 drives stick 1. | Joystick
T15 | Video | F8 50 / 60 Hz | F8, wait, F8 again. | 50 Hz picture, then 60 Hz again; the Atari keeps running; no line at the right edge. | -
T16 | Video | Graphics modes | GRAPHICS 7:COLOR 1:PLOT 0,0:DRAWTO 159,79 then GRAPHICS 8:COLOR 1:PLOT 0,0:DRAWTO 319,159 | A diagonal line in each mode, the second one thinner (hi-res). | -
T17 | Video | GTIA mode 9 (16 shades) | GRAPHICS 9:FOR I=0 TO 15:COLOR I:PLOT I*4,0:DRAWTO I*4,150:NEXT I:FOR I=1 TO 2000:NEXT I | 16 vertical bars from black to white in one colour. | -
T18 | Video | Colours | SETCOLOR 2,3,6 then SETCOLOR 4,9,4 | Background turns red-orange; then the border turns blue. | -
T19 | Video | Player graphics | 10 POKE 54279,128:POKE 559,46:POKE 53277,3:POKE 704,68:POKE 53248,120 20 FOR I=0 TO 127:POKE 33280+I,0:NEXT I 30 FOR I=50 TO 57:POKE 33280+I,255:NEXT I RUN | A small purple-red square in the middle of the screen, over the text. | -
T20 | Disk | .atr boot | F12, choose a bootable .atr (a DOS disk or a game). | Note "D1: name", the Atari restarts and boots it (the ESP32's serial log shows no errors). | .atr on the card
T21 | Disk | .atr write | Boot a DOS 2.x .atr (with BASIC), type 10 ?1, SAVE "D:TEST", NEW, LOAD "D:TEST", LIST. | Line 10 comes back; on the PC the .atr has changed (compare with the copy). | DOS .atr, PC copy
T22 | Disk | .xex | F12, choose an .xex game. | Note "Run: name", the Atari restarts, loads (a few seconds) and runs the program. | .xex on the card
T23 | Disk | .car | F12, choose a standard 8 KB or 16 KB .car, then an Atarimax 128 KB / 1 MB .car (many newer games). | Note "Cartridge: name", the Atari restarts into the cartridge. Other types: "Cart type not yet". | .car on the card
T24 | System | Screenshot | In BASIC with some text on the screen press Print Screen. | Note "Saved SCRNnnnn.BMP"; on the PC the BMP shows the Atari screen (376 x 240) in the right colours. | SD card
T25 | System | Back to the menu | Ctrl+Alt+Del in LTari; then KEY1 in LTari. | The menu each time; LSpectrum and L64 still start and work (F12 OSD in each). | -
T26 | System | KEY0 | In LTari press KEY0. | A fresh start into BASIC (cartridge removed); the ESP32 restarts, F12 works. | -

Sheet: Summary
LTari first test round
Hardware: L.jic and ESP32 sketch built 2026-10-29 evening (ESP32 still to upload)
Tests
Pass
Fail
Skipped
Not run yet
Done
How to use
Fill in only the yellow columns of 'Test Plan': Result (drop-down: Pass / Fail / Skipped) and Notes.
Notes example: "Fail: Error 138 after the second sector" or "Pass, booted in 6 s".
Keep a PC copy of every .atr you write to, and compare after the disk tests.
Type the BASIC lines exactly; on this keyboard + is the ' key, " is Shift+2, : is Shift+;, * is \.
The counts above update by themselves.
