alexlutsenko7/A_Computer/tests/jtag_rig/results/screens.png

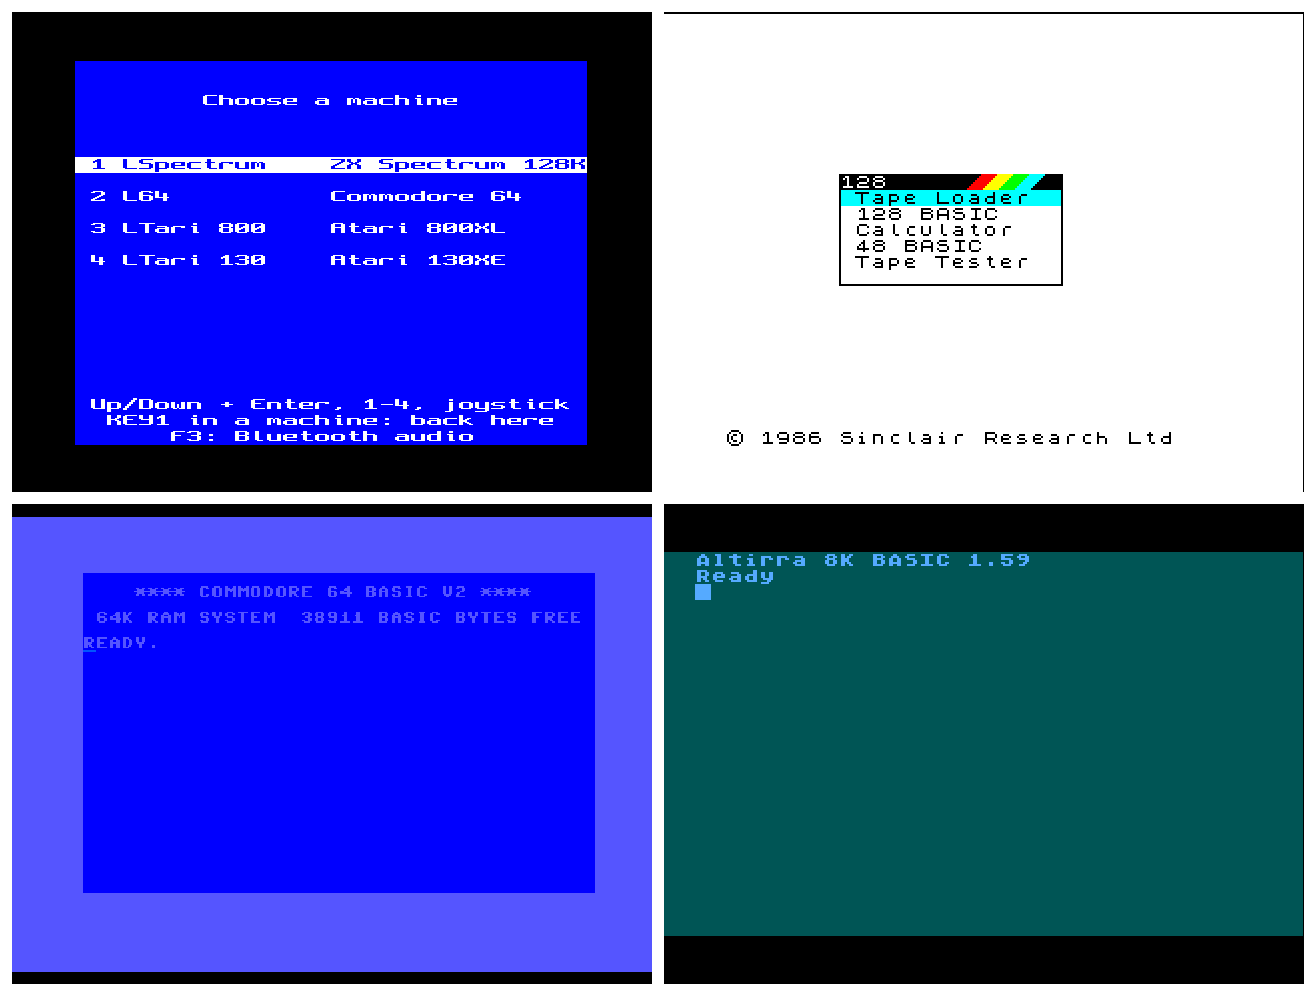
tests/jtag_rig/results/screens.png
