alexlutsenko7/A_Computer/Extra_PCB_CycloneIV_R2/Extra_PCB_CycloneIV_R2.pdf

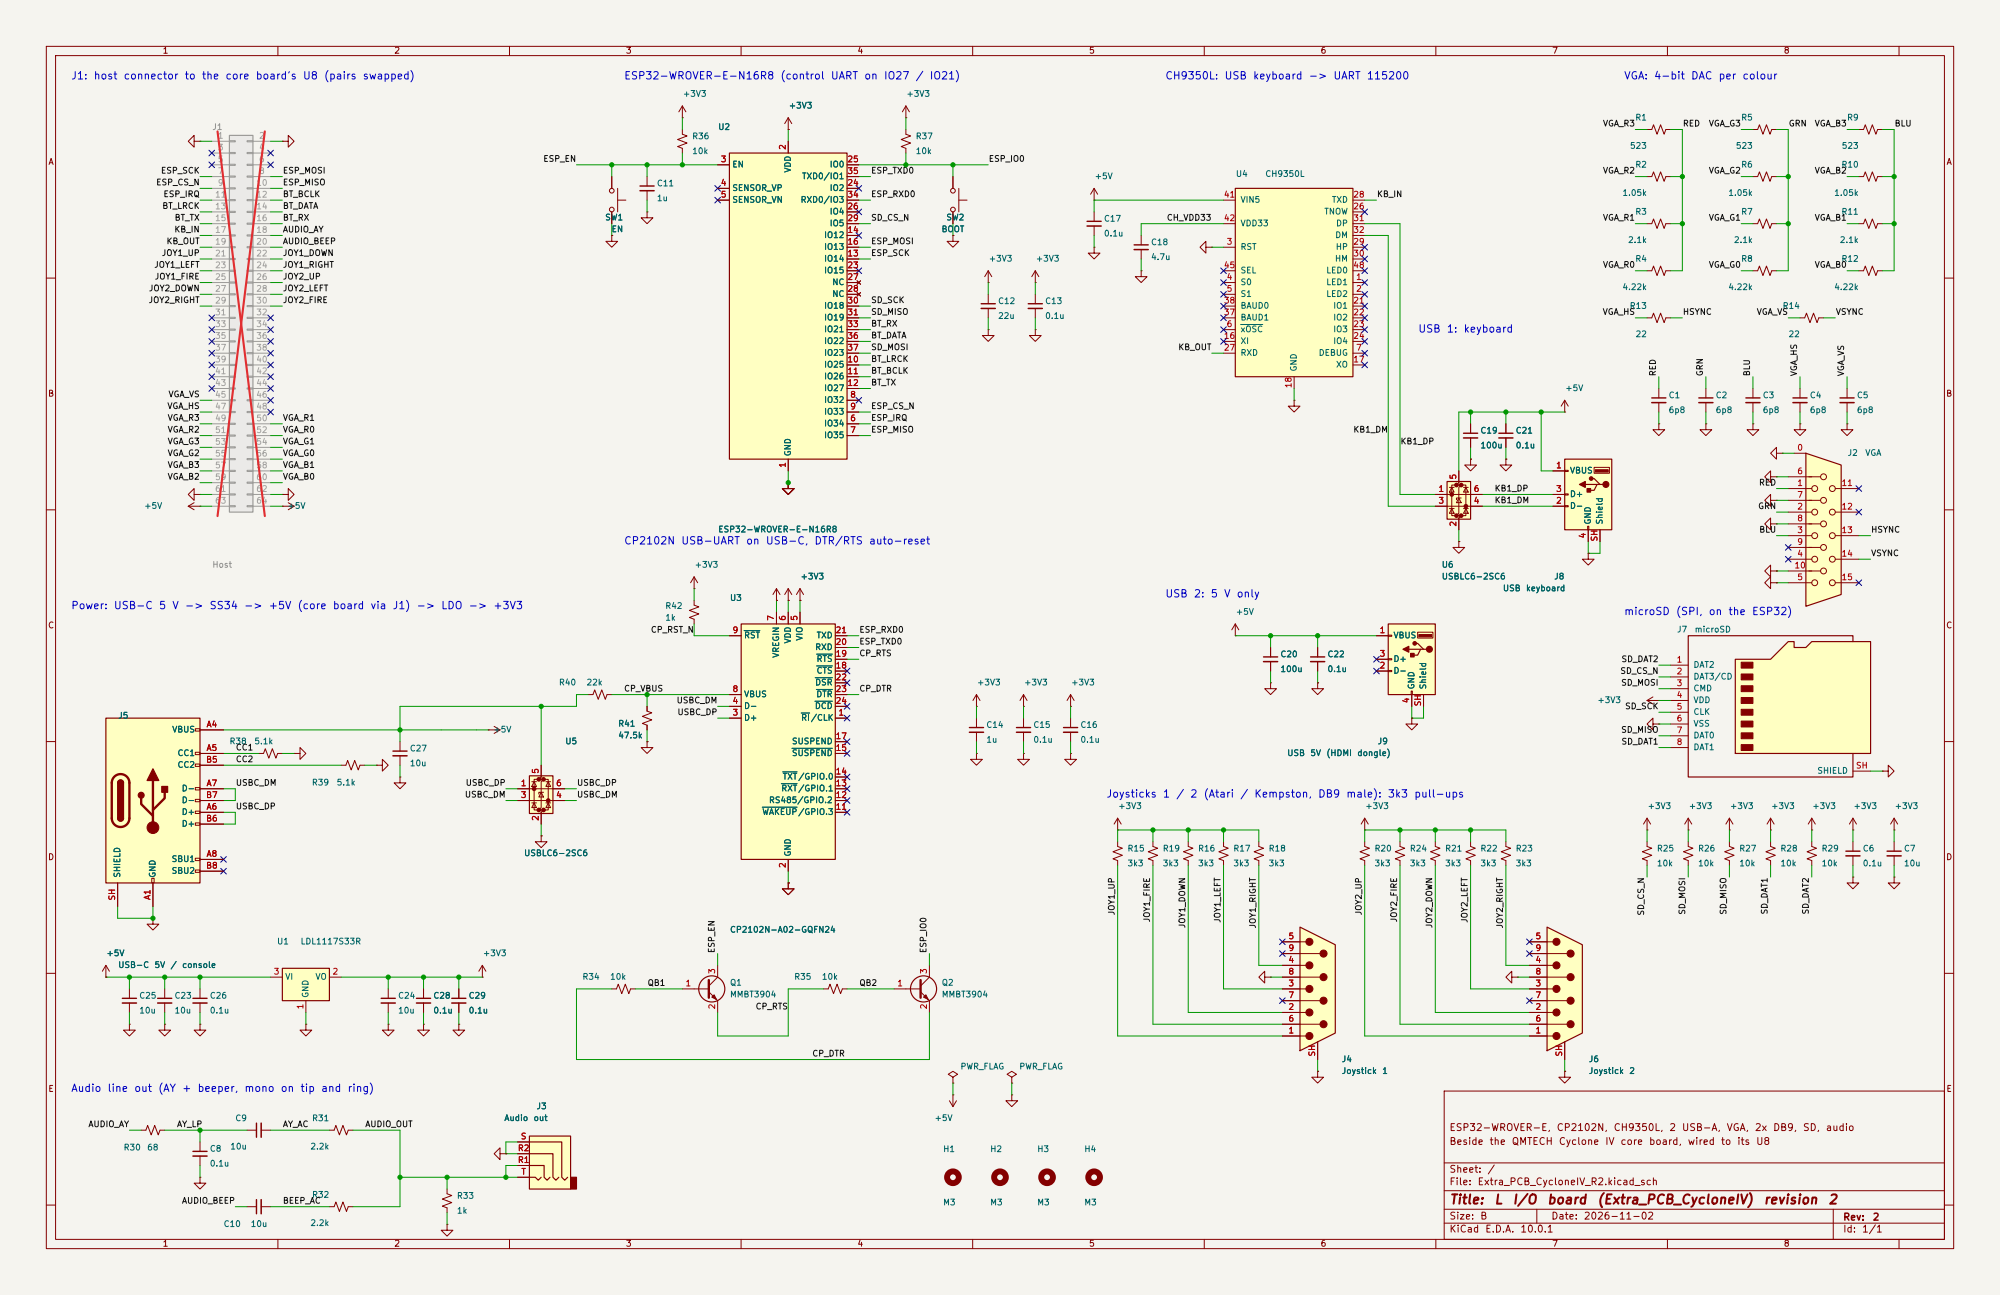
[picture p4: page 1]

KB1_DP Power: USB-C 5 V -> SS34 -> +5V (core board via J1) -> LDO -> +3V3

CP2102N USB-UART on USB-C, DTR/RTS auto-reset

microSD (SPI, on the ESP32)

SUSPEND 15 SUSPEND 17 CTS 18 RTS 19 RXD 20 TXD 21 DSR 22 DTR 23 DCD 24 U5 USBLC6-2SC6

Joysticks 1 / 2 (Atari / Kempston, DB9 male): 3k3 pull-ups

Audio line out (AY + beeper, mono on tip and ring)

ESP32-WROVER-E, CP2102N, CH9350L, 2 USB-A, VGA, 2x DB9, SD, audio
Beside the QMTECH Cyclone IV core board, wired to its U8

Size: B | Rev: 2
KiCad E.D.A. 10.0.1 | Id: 1/1
