alexlutsenko7/A_Computer/Extra_PCB_CycloneIV/Extra_PCB_CycloneIV.pdf

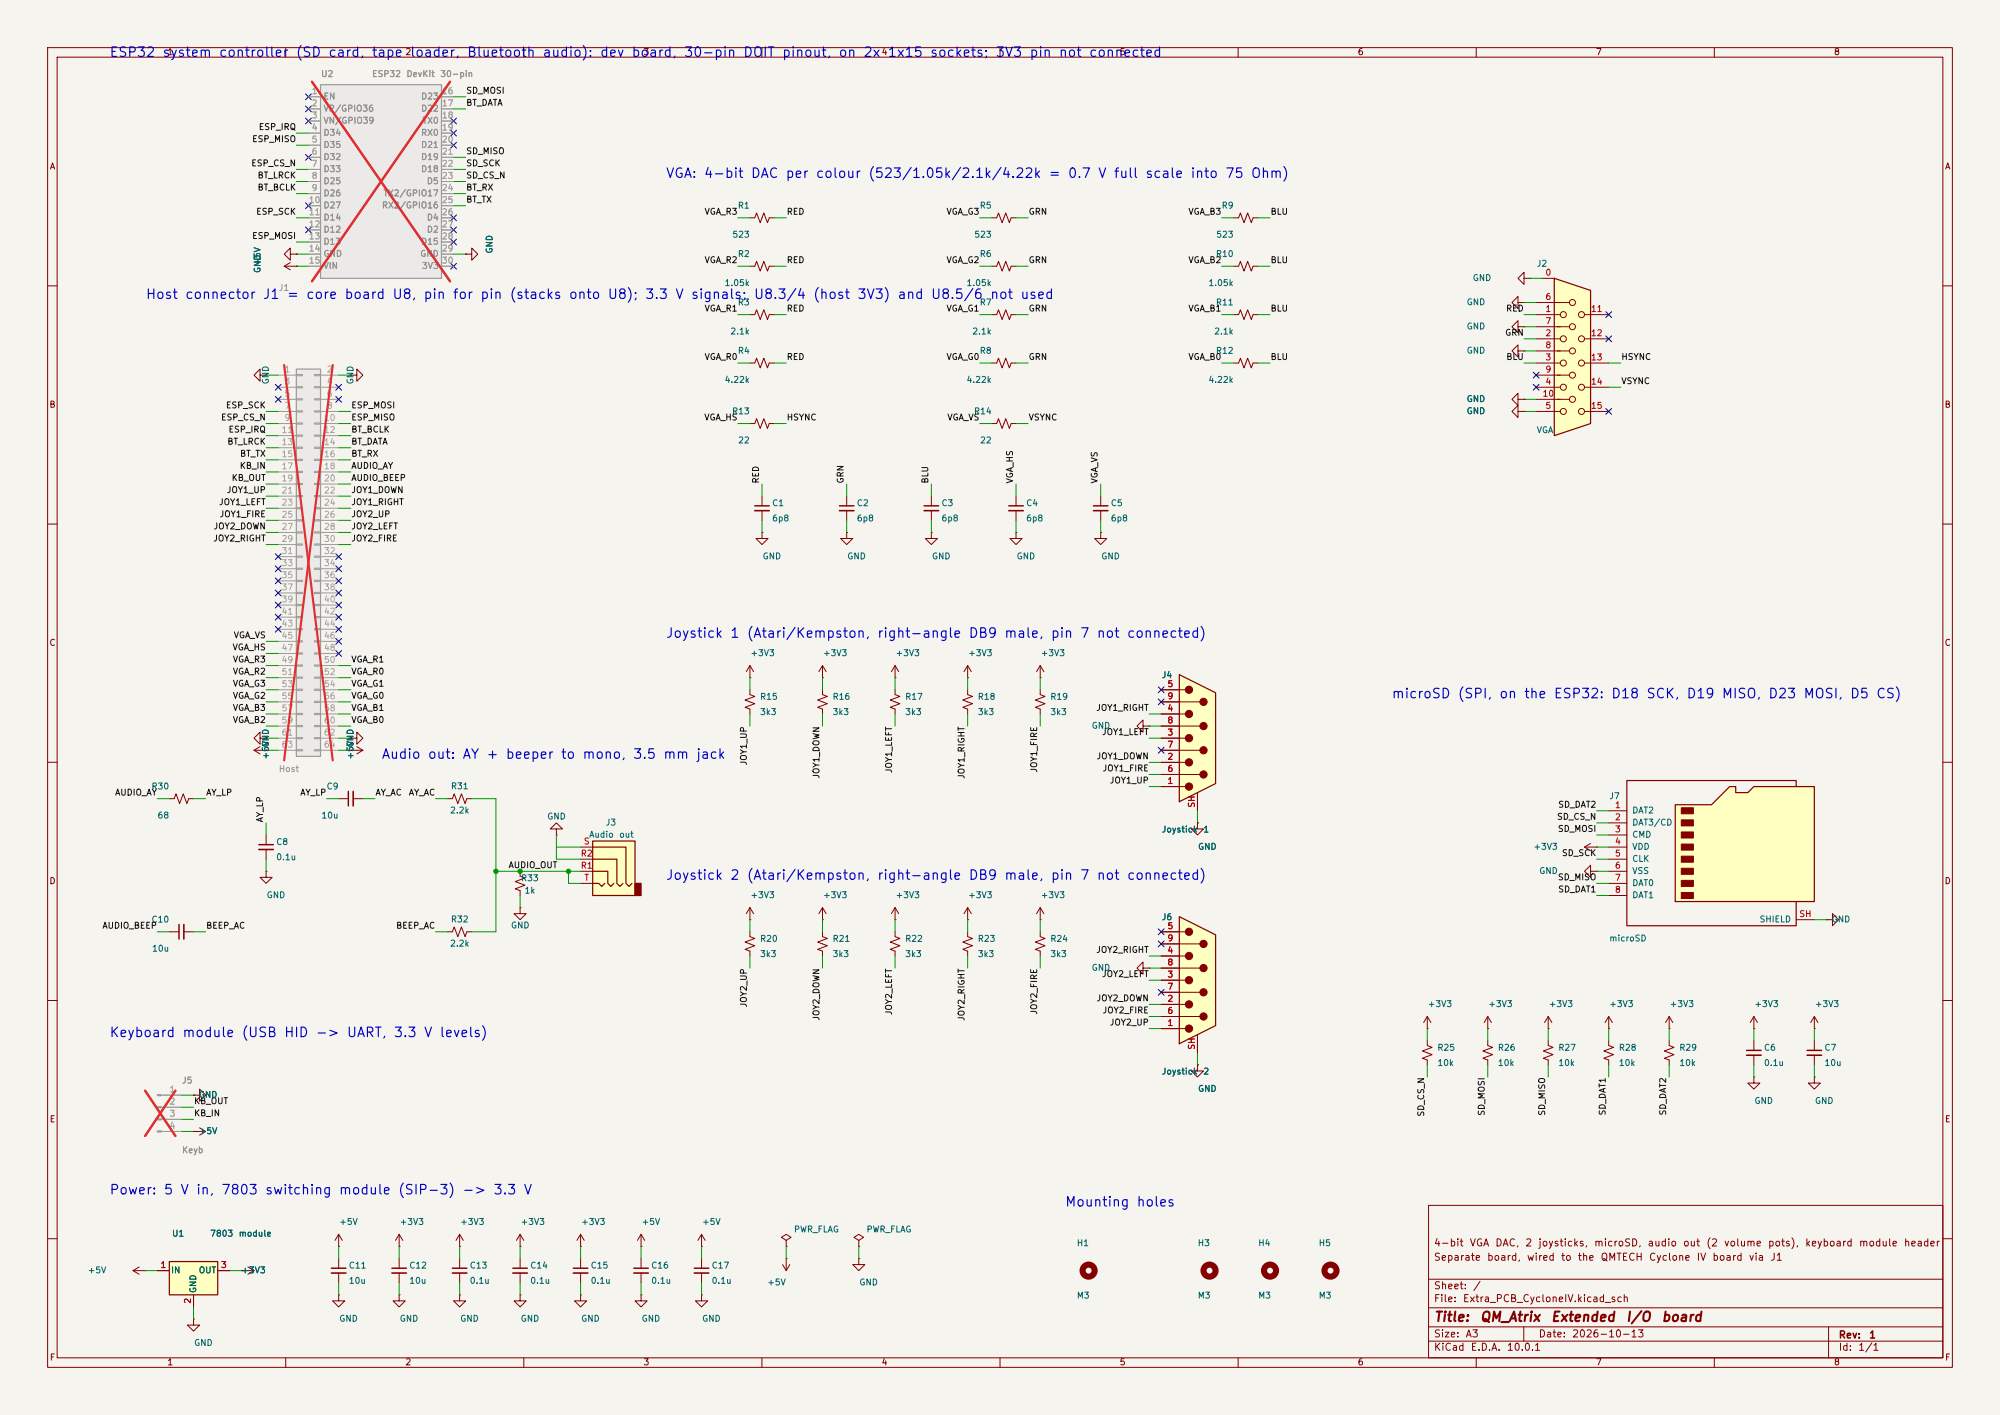
[picture p5: page 1]

ESP32 system controller (SD card, tape loader, Bluetooth audio): dev board, 30-pin DOIT pinout, on 2x 1x15 sockets; 3V3 pin not connected

VGA: 4-bit DAC per colour (523/1.05k/2.1k/4.22k = 0.7 V full scale into 75 Ohm)

Host connector J1 = core board U8, pin for pin (stacks onto U8); 3.3 V signals; U8.3/4 (host 3V3) and U8.5/6 not used

Joystick 1 (Atari/Kempston, right-angle DB9 male, pin 7 not connected)

Audio out: AY + beeper to mono, 3.5 mm jack

Power: 5 V in, 7803 switching module (SIP-3) -> 3.3 V

4-bit VGA DAC, 2 joysticks, microSD, audio out (2 volume pots), keyboard module header
Separate board, wired to the QMTECH Cyclone IV board via J1

Size: A3 | Rev: 1 | F Date: 2026-10-13
KiCad E.D.A. 10.0.1 | Id: 1/1
