alexlutsenko7/A_Computer/Extra_PCB_CycloneIV_R2/Extra_PCB_CycloneIV_R2.kicad_pcb

## KiCad design Extra_PCB_CycloneIV_R2/Extra_PCB_CycloneIV_R2.kicad_pcb (2026-11-09)

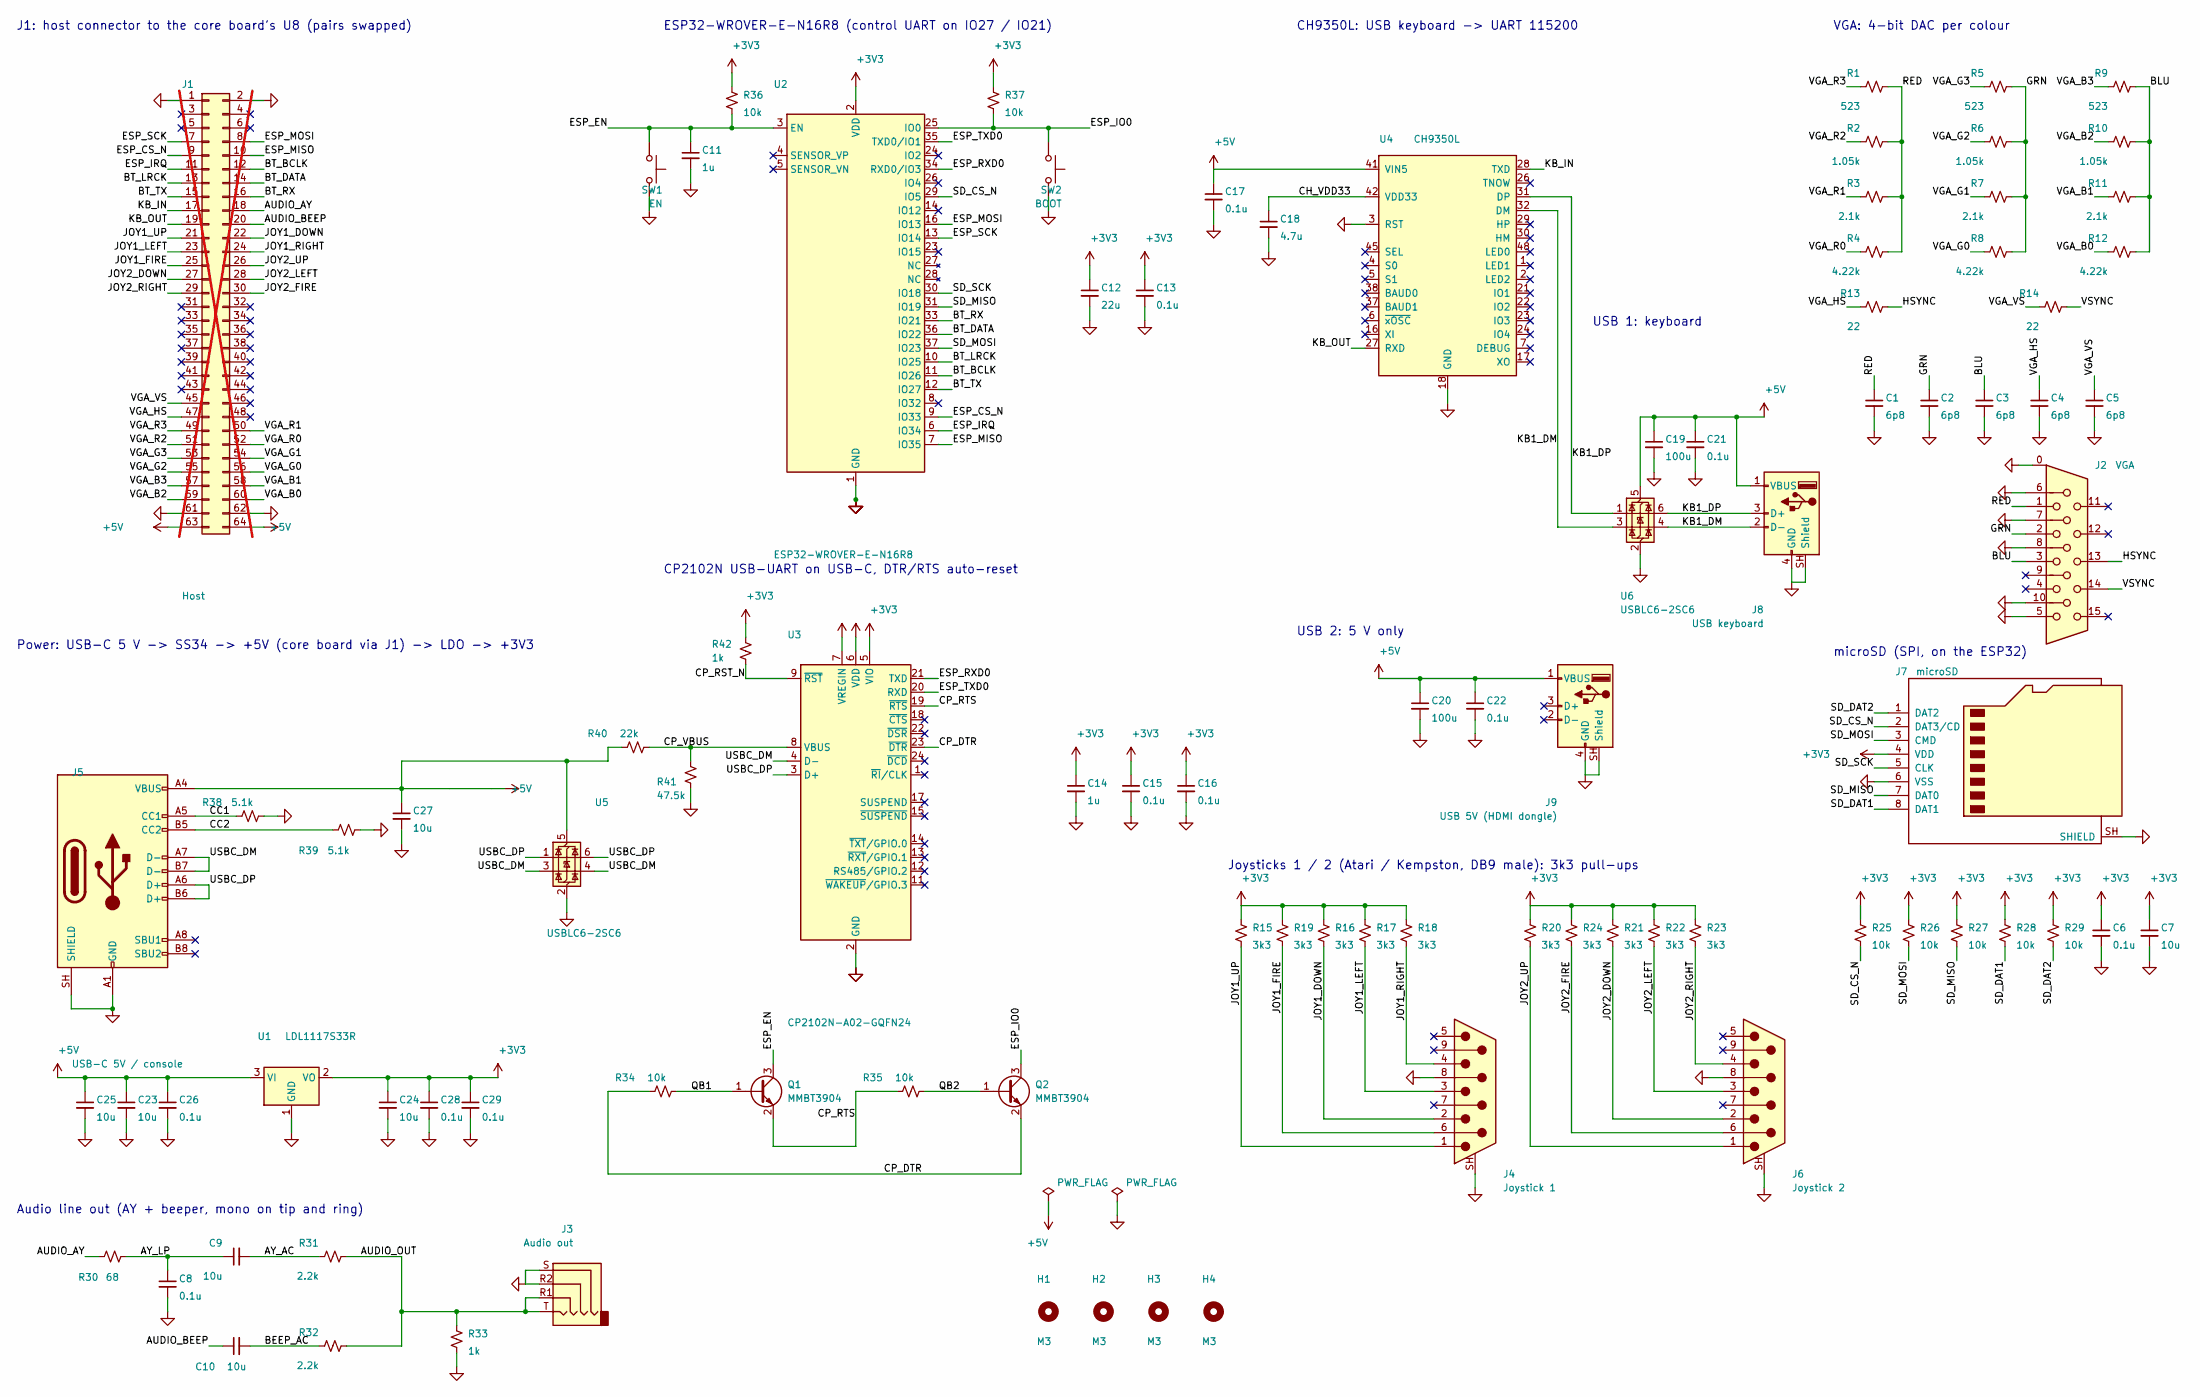
[picture p6: schematic Extra_PCB_CycloneIV_R2.kicad_sch, L I/O board (Extra_PCB_CycloneIV) revision 2]

Parts:
C1, C2, C3, C4, C5: 6p8; C_0603_1608Metric
C6, C8, C13, C15, C16, C17, C21, C22, C26, C28, C29: 0.1u; C_0603_1608Metric
C7, C9, C10, C23, C24, C25, C27: 10u; C_0805_2012Metric
C11, C14: 1u; C_0603_1608Metric
C12: 22u; C_0805_2012Metric
C18: 4.7u; C_0603_1608Metric
C19, C20: 100u; C_1206_3216Metric
H1, H2, H3, H4: M3; MountingHole_3.2mm_M3
J1: Host; PinHeader_2x32_P2.54mm_Vertical_RowsSwapped; not fitted
J2: VGA; DSUB-15-HD_Socket_Horizontal_P2.29x2.54mm_CONNFLY_DS1038; MPN DS1038-15FBNSiA74-0CC
J3: Audio out; Jack_3.5mm_KoreanHropartsElec_PJ-320D-4A_Horizontal; MPN PJ-320D-4A
J4: Joystick 1; DSUB-9_Pins_Horizontal_P2.77x2.84mm_EdgePinOffset7.70mm_Hou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; MPN DS1037-09MNAKT74-0CC
J5: USB-C 5V / console; USB_C_Receptacle_HRO_TYPE-C-31-M-12; MPN TYPE-C-31-M-12
J6: Joystick 2; DSUB-9_Pins_Horizontal_P2.77x2.84mm_EdgePinOffset7.70mm_Hou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; MPN DS1037-09MNAKT74-0CC
J7: microSD; microSD_HC_Molex_104031-0811; MPN 104031-0811
J8: USB keyboard; USB_A_Connfly_DS1095; MPN DS1095-WNR0
J9: USB 5V (HDMI dongle); USB_A_Connfly_DS1095; MPN DS1095-WNR0
Q1, Q2: MMBT3904; SOT-23; MPN MMBT3904
R1, R5, R9: 523; R_0603_1608Metric
R2, R6, R10: 1.05k; R_0603_1608Metric
R3, R7, R11: 2.1k; R_0603_1608Metric
R4, R8, R12: 4.22k; R_0603_1608Metric
R13, R14: 22; R_0603_1608Metric
R15, R16, R17, R18, R19, R20, R21, R22, R23, R24: 3k3; R_0603_1608Metric
R25, R26, R27, R28, R29, R34, R35, R36, R37: 10k; R_0603_1608Metric
R30: 68; R_0603_1608Metric
R31, R32: 2.2k; R_0603_1608Metric
R33, R42: 1k; R_0603_1608Metric
R38, R39: 5.1k; R_0603_1608Metric
R40: 22k; R_0603_1608Metric
R41: 47.5k; R_0603_1608Metric
SW1: EN; SW_SPST_PTS810; MPN PTS810SJM250SMTRLFS
SW2: BOOT; SW_SPST_PTS810; MPN PTS810SJM250SMTRLFS
U1: LDL1117S33R; SOT-223-3_TabPin2; MPN LDL1117S33R
U2: ESP32-WROVER-E-N16R8; ESP32-WROVER-E; MPN ESP32-WROVER-E-N16R8
U3: CP2102N-A02-GQFN24; QFN-24-1EP_4x4mm_P0.5mm_EP2.6x2.6mm; MPN CP2102N-A02-GQFN24R
U4: CH9350L; LQFP-48_7x7mm_P0.5mm; MPN CH9350L
U5, U6: USBLC6-2SC6; SOT-23-6; MPN USBLC6-2SC6

Connections:
+3V3: C6.1, C7.1, C12.1, C13.1, C14.1, C15.1, C16.1, C24.1, C28.1, C29.1, J7.4 (VDD), R15.1, R16.1, R17.1, R18.1, R19.1, R20.1, R21.1, R22.1, R23.1, R24.1, R25.1, R26.1, R27.1, R28.1, R29.1, R36.1, R37.1, R42.1, U1.2 (VO), U2.2 (VDD), U3.5 (VIO), U3.6 (VDD), U3.7 (VREGIN)
+5V: C17.1, C19.1, C20.1, C21.1, C22.1, C23.1, C25.1, C26.1, C27.1, J1.63, J1.64, J5.A4 (VBUS), J5.A9 (VBUS), J5.B4 (VBUS), J5.B9 (VBUS), J8.1 (VBUS), J9.1 (VBUS), R40.1, U1.3 (VI), U4.41 (VIN5), U5.5 (VBUS), U6.5 (VBUS)
/AUDIO_AY: J1.18, R30.1
/AUDIO_BEEP: C10.1, J1.20
/AUDIO_OUT: J3.R1, J3.T, R31.2, R32.2, R33.1
/AY_AC: C9.2, R31.1
/AY_LP: C8.1, C9.1, R30.2
/BEEP_AC: C10.2, R32.1
/BLU: C3.1, J2.3, R9.2, R10.2, R11.2, R12.2
/BT_BCLK: J1.12, U2.11 (IO26)
/BT_DATA: J1.14, U2.36 (IO22)
/BT_LRCK: J1.13, U2.10 (IO25)
/BT_RX: J1.16, U2.33 (IO21)
/BT_TX: J1.15, U2.12 (IO27)
/CC1: J5.A5 (CC1), R38.1
/CC2: J5.B5 (CC2), R39.1
/CH_VDD33: C18.1, U4.42 (VDD33)
/CP_DTR: Q2.2 (E), R34.1, U3.23 (~DTR)
/CP_RST_N: R42.2, U3.9 (~RST)
/CP_RTS: Q1.2 (E), R35.1, U3.19 (~RTS)
/CP_VBUS: R40.2, R41.1, U3.8 (VBUS)
/ESP_CS_N: J1.9, U2.9 (IO33)
/ESP_EN: C11.1, Q1.3 (C), R36.2, SW1.1, U2.3 (EN)
/ESP_IO0: Q2.3 (C), R37.2, SW2.1, U2.25 (IO0)
/ESP_IRQ: J1.11, U2.6 (IO34)
/ESP_MISO: J1.10, U2.7 (IO35)
/ESP_MOSI: J1.8, U2.16 (IO13)
/ESP_RXD0: U2.34 (RXD0/IO3), U3.21 (TXD)
/ESP_SCK: J1.7, U2.13 (IO14)
/ESP_TXD0: U2.35 (TXD0/IO1), U3.20 (RXD)
/GRN: C2.1, J2.2, R5.2, R6.2, R7.2, R8.2
/HSYNC: J2.13, R13.2
/JOY1_DOWN: J1.22, J4.2, R16.2
/JOY1_FIRE: J1.25, J4.6, R19.2
/JOY1_LEFT: J1.23, J4.3, R17.2
/JOY1_RIGHT: J1.24, J4.4, R18.2
/JOY1_UP: J1.21, J4.1, R15.2
/JOY2_DOWN: J1.27, J6.2, R21.2
/JOY2_FIRE: J1.30, J6.6, R24.2
/JOY2_LEFT: J1.28, J6.3, R22.2
/JOY2_RIGHT: J1.29, J6.4, R23.2
/JOY2_UP: J1.26, J6.1, R20.2
/KB1_DM: J8.2 (D-), U4.32 (DM), U6.3 (I/O2), U6.4 (I/O2)
/KB1_DP: J8.3 (D+), U4.31 (DP), U6.1 (I/O1), U6.6 (I/O1)
/KB_IN: J1.17, U4.28 (TXD)
/KB_OUT: J1.19, U4.27 (RXD)
/QB1: Q1.1 (B), R34.2
/QB2: Q2.1 (B), R35.2
/RED: C1.1, J2.1, R1.2, R2.2, R3.2, R4.2
/SD_CS_N: J7.2 (DAT3/CD), R25.2, U2.29 (IO5)
/SD_DAT1: J7.8 (DAT1), R28.2
/SD_DAT2: J7.1 (DAT2), R29.2
/SD_MISO: J7.7 (DAT0), R27.2, U2.31 (IO19)
/SD_MOSI: J7.3 (CMD), R26.2, U2.37 (IO23)
/SD_SCK: J7.5 (CLK), U2.30 (IO18)
/USBC_DM: J5.A7 (D-), J5.B7 (D-), U3.4 (D-), U5.3 (I/O2), U5.4 (I/O2)
/USBC_DP: J5.A6 (D+), J5.B6 (D+), U3.3 (D+), U5.1 (I/O1), U5.6 (I/O1)
/VGA_B0: J1.60, R12.1
/VGA_B1: J1.58, R11.1
/VGA_B2: J1.59, R10.1
/VGA_B3: J1.57, R9.1
/VGA_G0: J1.56, R8.1
/VGA_G1: J1.54, R7.1
/VGA_G2: J1.55, R6.1
/VGA_G3: J1.53, R5.1
/VGA_HS: C4.1, J1.47, R13.1
/VGA_R0: J1.52, R4.1
/VGA_R1: J1.50, R3.1
/VGA_R2: J1.51, R2.1
/VGA_R3: J1.49, R1.1
/VGA_VS: C5.1, J1.45, R14.1
/VSYNC: J2.14, R14.2
GND: C1.2, C2.2, C3.2, C4.2, C5.2, C6.2, C7.2, C8.2, C11.2, C12.2, C13.2, C14.2, C15.2, C16.2, C17.2, C18.2, C19.2, C20.2, C21.2, C22.2, C23.2, C24.2, C25.2, C26.2, C27.2, C28.2, C29.2, J1.1, J1.2, J1.61, J1.62, J2.0 (GND), J2.5, J2.6, J2.7, J2.8, J2.10, J3.R2, J3.S, J4.8, J4.SH (PAD), J5.A1 (GND), J5.A12 (GND), J5.B1 (GND), J5.B12 (GND), J5.SH (SHIELD), J6.8, J6.SH (PAD), J7.6 (VSS), J7.SH (SHIELD), J8.4 (GND), J8.SH (Shield), J9.4 (GND), J9.SH (Shield), R33.2, R38.2, R39.2, R41.2, SW1.2, SW2.2, U1.1 (GND), U2.1 (GND), U2.15 (GND), U2.38 (GND), U2.39 (GND), U3.2 (GND), U3.25 (GND), U4.3 (RST), U4.18 (GND), U5.2 (GND), U6.2 (GND)

Notes on the sheet:
Audio line out (AY + beeper, mono on tip and ring)
Joysticks 1 / 2 (Atari / Kempston, DB9 male): 3k3 pull-ups
microSD (SPI, on the ESP32)
VGA: 4-bit DAC per colour
Power: USB-C 5 V -> SS34 -> +5V (core board via J1) -> LDO -> +3V3
USB 2: 5 V only
ESP32-WROVER-E-N16R8 (control UART on IO27 / IO21)
J1: host connector to the core board's U8 (pairs swapped)
CP2102N USB-UART on USB-C, DTR/RTS auto-reset
CH9350L: USB keyboard -> UART 115200
USB 1: keyboard

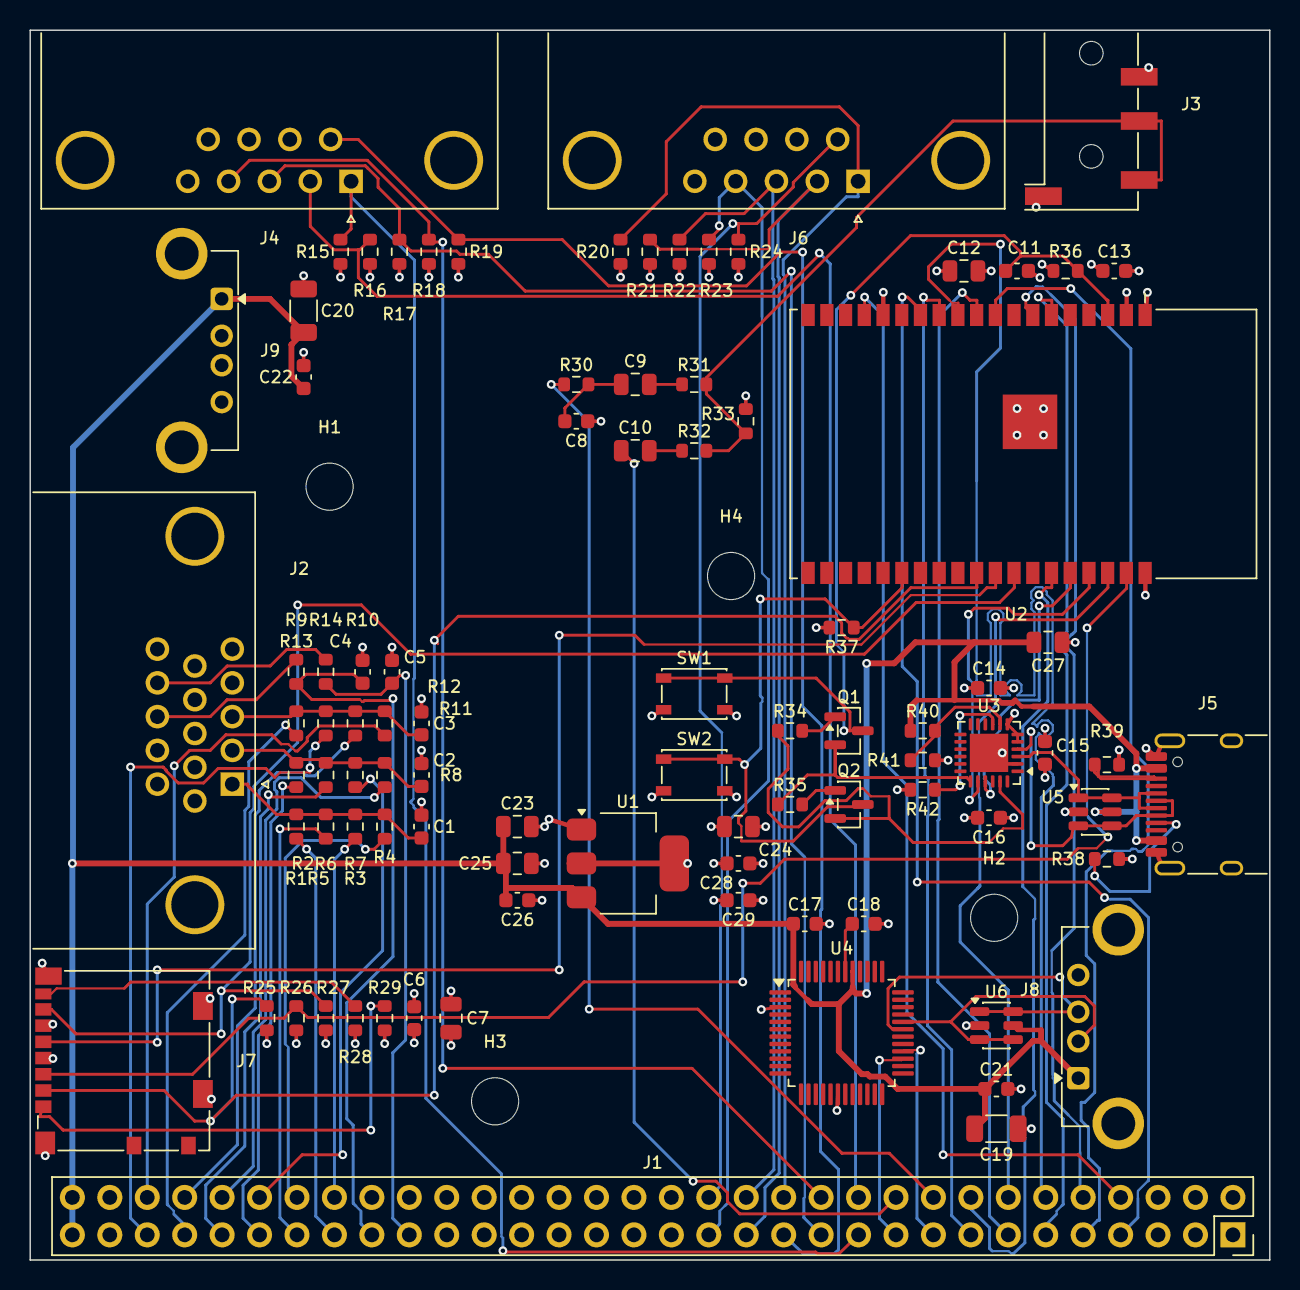
[picture p7: board Extra_PCB_CycloneIV_R2.kicad_pcb from above]

Board: 4 copper layers, 84.1 x 83.4 mm, 94 parts (0 on the bottom side), 73 nets.
