alexlutsenko7/A_Computer/AMenu/ep4_ce15/rtl/AMenu.v

/* AMenu -- machine menu, the factory image of the config flash */
/* */
/* Loaded at every power-up (and when a machine returns with KEY1). Shows the */
/* machines on 640x480@60 and starts the chosen one through the Cyclone IV */
/* remote update block (menu_boot): its bitstream is at MACHINE_ADDR in the */
/* flash (docs/PLAN.md "machine menu"). If that image is missing or damaged the */
/* device comes back here, and the menu shows the error under the machine. */
/* */
/* Keys: Up / Down (cursor and keypad 8 / 2), Enter / keypad Enter = start, */
/* 1 .. N (also keypad) = start that machine; joysticks: up / down / fire. */
/* After a machine returned, the cursor is on that machine. */
/* */
/* Clocks: CLOCK_50 (keyboard, menu), vga_pll c0 = 25.208 MHz (video), */
/* ruclk = CLOCK_50 / 4 = 12.5 MHz (remote update block, at most 20 MHz). */
/* LED: on = menu, blinking = the last machine could not start; the error row shows the */
/* reconfiguration reason in hex (02 watchdog, 04 nSTATUS / no image, 08 CRC, 10 nCONFIG). */
/* ESP32 link (as the machines: tape_loader + esp_link at mclk = 75 MHz, core ID 4D4E_0002 "MN", */
/* link version 2 = flash stream frames): the ESP32 draws on an OSD screen (shown instead of the */
/* menu while OSD is on; the menu takes no input meanwhile) and reads / writes the configuration */
/* flash through the FLASH register, DCLK 18.75 MHz (FL_HALF 2), mostly with FLS frames (1 us per byte): */
/* flash update from the SD card (LUPDATE.BIN), "no machines installed" (ESP32/v2/src/update.cpp). */
/* F3 opens the ESP32's Bluetooth menu (loader keys + the UART to its Bluetooth part, BT_TX / BT_RX). */
/* All other I/O board pins stay inputs (weak pull-ups): the SDRAM is deselected (CS_N high). */
`default_nettype none

module AMenu #(
    parameter integer N_MACHINES = 4,
/* machine i at [24*i +: 24] (1 MB slots) */
    parameter [95:0]  MACHINE_ADDR = {24'h400000, 24'h300000, 24'h200000, 24'h100000},
/* Spleen 8x16 (font/, tools/mk_menufont.py) */
    parameter         FONT_HEX = "rtl/menu_font.hex",
    parameter         TEXT_HEX = "rtl/menu_text.hex"
)(
    input  wire       CLOCK_50,
    input  wire       RESET_N,
    output wire       LEDR,

    output reg  [3:0] VGA_R,
    output reg  [3:0] VGA_G,
    output reg  [3:0] VGA_B,
    output reg        VGA_HS,
    output reg        VGA_VS,

    input  wire       KB_OUT,
    input  wire       KB_IN,

    output wire       AUDIO_AY,
    output wire       AUDIO_BEEP,

    input  wire       JOY1_UP_N,
    input  wire       JOY1_DOWN_N,
    input  wire       JOY1_FIRE_N,
    input  wire       JOY2_UP_N,
    input  wire       JOY2_DOWN_N,
    input  wire       JOY2_FIRE_N,

    input  wire       ESP_SCK,
    input  wire       ESP_MOSI,
    input  wire       ESP_CS_N,
    output wire       ESP_MISO,
    output wire       ESP_IRQ,
/* UART to the ESP32's Bluetooth part (its RX2, GPIO16): F3 menu */
    output wire       BT_TX,
/* UART from it (its TX2, GPIO17) */
    input  wire       BT_RX
);

/* USB key code: cursor up */
localparam [7:0] KEY_UP = 8'h52;
/* USB key code: keypad 8 (up) */
localparam [7:0] KEY_KP8 = 8'h60;
/* USB key code: cursor down */
localparam [7:0] KEY_DOWN = 8'h51;
/* USB key code: keypad 2 (down) */
localparam [7:0] KEY_KP2 = 8'h5A;
/* USB key code: Enter */
localparam [7:0] KEY_ENTER = 8'h28;
/* USB key code: keypad Enter */
localparam [7:0] KEY_KP_ENTER = 8'h58;
/* USB key code of the key 1, minus 1 (digit n = base + n) */
localparam [7:0] KEY_DIGIT_BASE = 8'h1D;
/* USB key code of keypad 1, minus 1 (keypad n = base + n) */
localparam [7:0] KEY_KP_BASE = 8'h58;

assign AUDIO_AY   = 1'b0;
assign AUDIO_BEEP = 1'b0;

/* Clocks and resets */
wire pclk, vga_locked;

vga_pll u_vpll (
    .inclk0 (CLOCK_50),
    .c0     (pclk),
    .c1     (),
    .locked (vga_locked)
);

wire mclk, m_locked;

/* 75 MHz for the ESP32's link */
menu_pll u_mpll (
    .inclk0 (CLOCK_50),
    .c0     (mclk),
    .locked (m_locked)
);
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
