alexlutsenko7/A_Computer/(commit log)

2026-10-31 Public release of Aspectrum, LAtari, and A64 computers
    [L64_Test_Plan.xlsx, LTari_Test_Plan.xlsx]
2026-11-02 LTari .atr BASIC prompt, fast SD flash update, Bluetooth fixes
    - LTari: Enter on an .atr asks F1 No BASIC / F2 with BASIC (OPTION held at boot)
    - Machine menu: FLS link frame streams the flash, update ~6x faster; F3 Bluetooth menu
    - ESP32: machine switch no longer restarts it (Bluetooth stays connected);
    I2S drift correction fixes short audio skips; audio counters in F3
    [AMenu.v, LTari.v, atari.cpp, atari.h, bt.cpp, c64.cpp, c64rom_test.cpp]
2026-11-02 1 MB flash slots, I/O board revision 1, ESP32 Bluetooth/loader recovery
    Flash layout in 1 MB slots (room for larger FPGAs, e.g. QMTECH 10CL025):
    - menu 0x000000, LSpectrum 0x100000, L64 0x200000, LTari 800 0x300000,
    LTari 130 0x400000, ZX ROMs 0x500000, Atari ROMs 0x540000,
    C64 ROMs (installed by the ESP32) 0x580000
    - AMenu: new machine addresses; menu_boot keeps 26 address bits so the
    remote-update block's shifted boot address still matches
    - L64 core ID 4336_0002 (older ESP32 firmware would write the C64 ROMs
    into the new L64 slot); C64 ROMs reinstall at the first L64 start
    - mk_update.py, ESP32 update.cpp / c64.cpp, sims and host tests updated
    - all images timing-clean (L64 SEED 3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
    [Extra_PCB_CycloneIV-B_Cu.gbl, Extra_PCB_CycloneIV-B_Mask.gbs, Extra_PCB_CycloneIV-B_Paste.gbp, Extra_PCB_CycloneIV-B_Silkscreen.gbo, Extra_PCB_CycloneIV-Edge_Cuts.gm1, Extra_PCB_CycloneIV-F_Cu.gtl, Extra_PCB_CycloneIV-F_Mask.gts, Extra_PCB_CycloneIV-F_Paste.gtp]
2026-11-03 I/O board revision 2: ESP32-WROVER-E, USB-C console, CH9350L keyboard, 4 layers
    New folder Extra_PCB_CycloneIV_R2 (KiCad 10), ordered at JLCPCB 2026-11-03:
    - ESP32-WROVER-E-N16R8 module on the board (16 MB flash, 8 MB PSRAM)
    - CP2102N on USB-C: console, auto-reset, 5 V input (also feeds the core board via J1)
    - CH9350L with a USB-A keyboard socket; second USB-A with 5 V for a VGA2HDMI dongle
    - VGA DAC, two DB9 joysticks, audio jack, microSD as revision 1; same J1 to the core board's U8
    - 4 layers (GND and +3V3 planes), ESP32 antenna keep-out, nothing past the board edge
    - JLCPCB order files (Gerbers, BOM, CPL); Basic-part swaps after the first order
    Docs: README, BUILDING_AND_LICENSES, PLAN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
    [Extra_PCB_CycloneIV_R2-B_Cu.gbl, Extra_PCB_CycloneIV_R2-B_Mask.gbs, Extra_PCB_CycloneIV_R2-B_Paste.gbp, Extra_PCB_CycloneIV_R2-B_Silkscreen.gbo, Extra_PCB_CycloneIV_R2-Edge_Cuts.gm1, Extra_PCB_CycloneIV_R2-F_Cu.gtl, Extra_PCB_CycloneIV_R2-F_Mask.gts, Extra_PCB_CycloneIV_R2-F_Paste.gtp]
2026-11-05 New rework around bug on the BT sound
    [AMenu.v, atari.cpp, atari.h, bt.cpp, bt.h, bt_i2s.v]
2026-11-05 FirstLight: the book's Chapter 4 project (LED, KEY1, color bars and gray ramp, 640x480@60 / 576p50); works on hardware
2026-11-05 FirstLight: whole-design testbench with PLL and clock-switch models
2026-11-10 ESP32 updated to get BT working without issues
    [esp_hw.cpp]
2026-11-11 Major rework: 1. Added new FPGA platform 2. All code rewritten with comments and to follow the rules
    [AMenu.v, DDR_TEST.v, DDR_TEST_C10.v, L64.v]
