alexlutsenko7/A_Computer/(notices)

Notices in the files:
L64/ep4_ce15/rtl/vicii/vicii.v:
This program is free software: you can redistribute it and/or modify
it under the terms of the GNU General Public License as published by
the Free Software Foundation, version 3.
